Sergey-V-Z/IR_Controller/Schem/IRController/IRController1.jpg

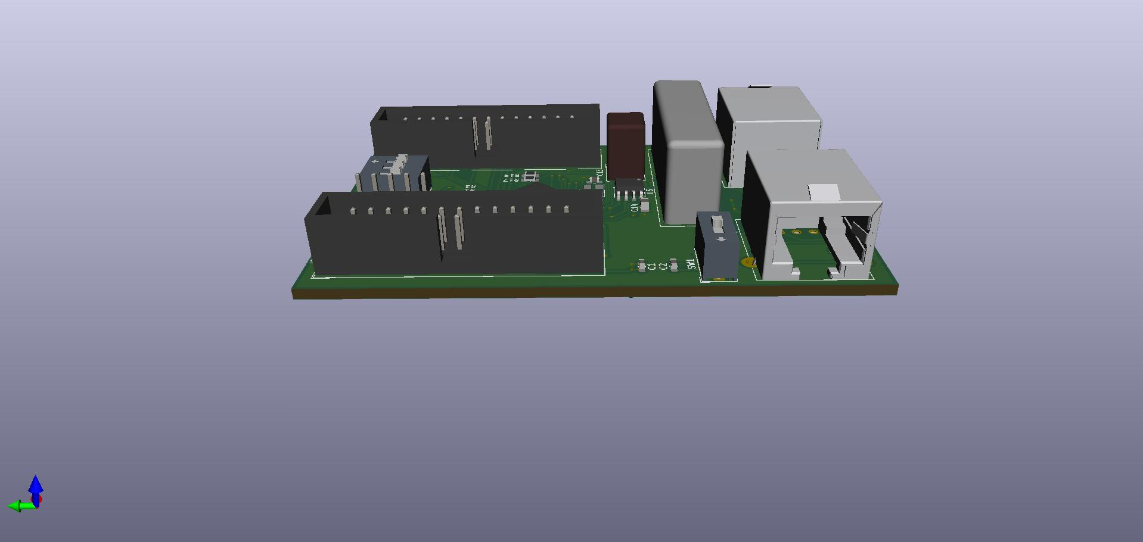
Schem/IRController/IRController1.jpg
