Sergey-V-Z/IR_Controller/Schem/IRController/IRController2.jpg

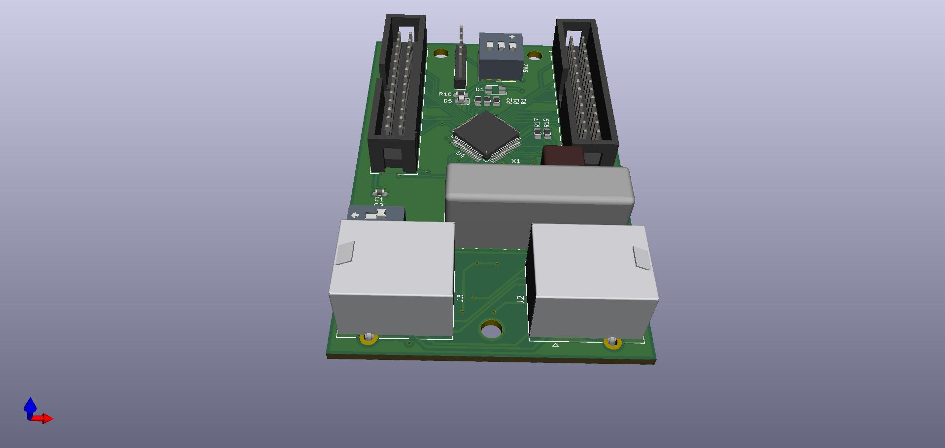
Schem/IRController/IRController2.jpg
