Sergey-V-Z/IR_Controller/Schem/IRController/IRController3.jpg

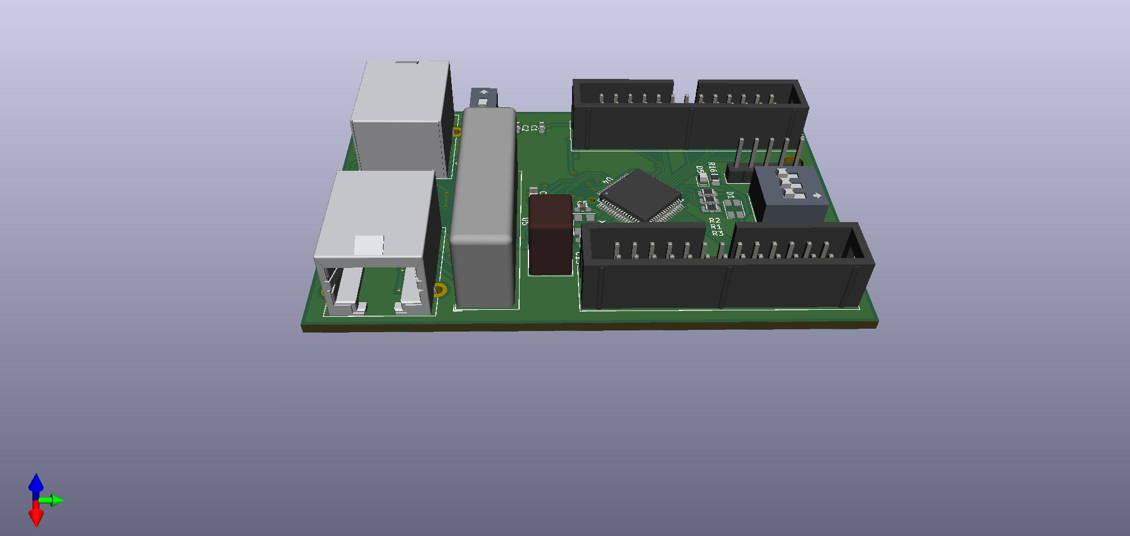
Schem/IRController/IRController3.jpg
