Sergey-V-Z/IR_Controller/Schem/IRController/IRController4.jpg

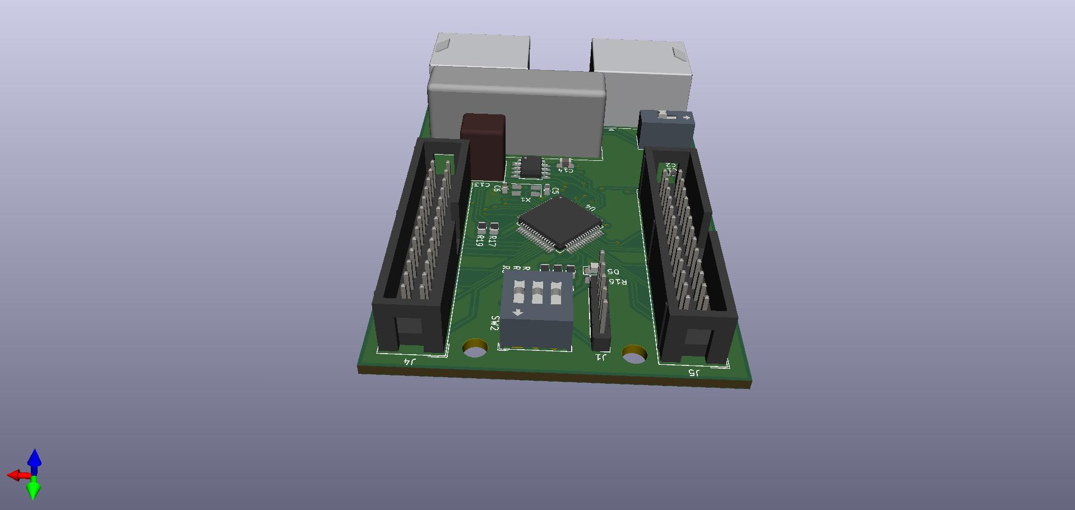
Schem/IRController/IRController4.jpg
