Sergey-V-Z/IR_Controller/Schem/IRController/IRController5.jpg

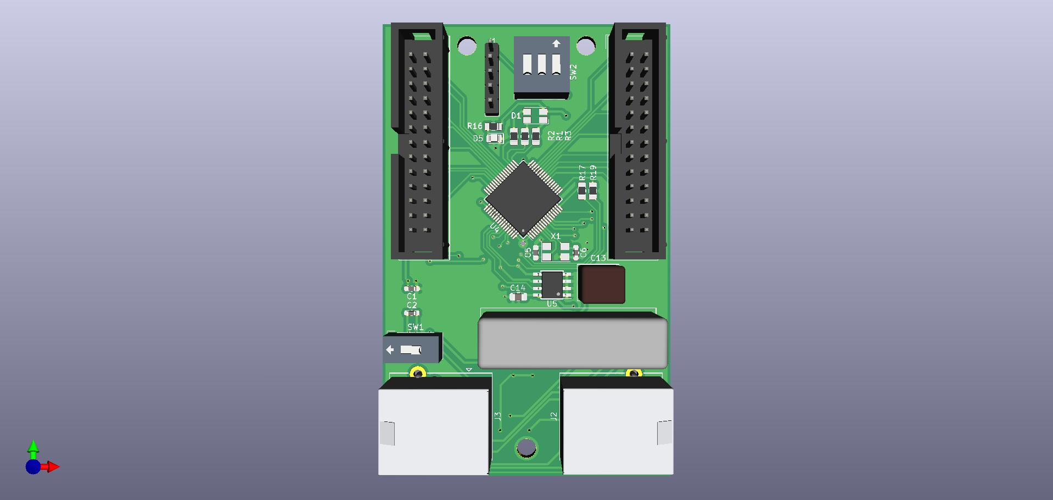
Schem/IRController/IRController5.jpg
