Sergey-V-Z/IR_Controller/Schem/IRController/IRController6.jpg

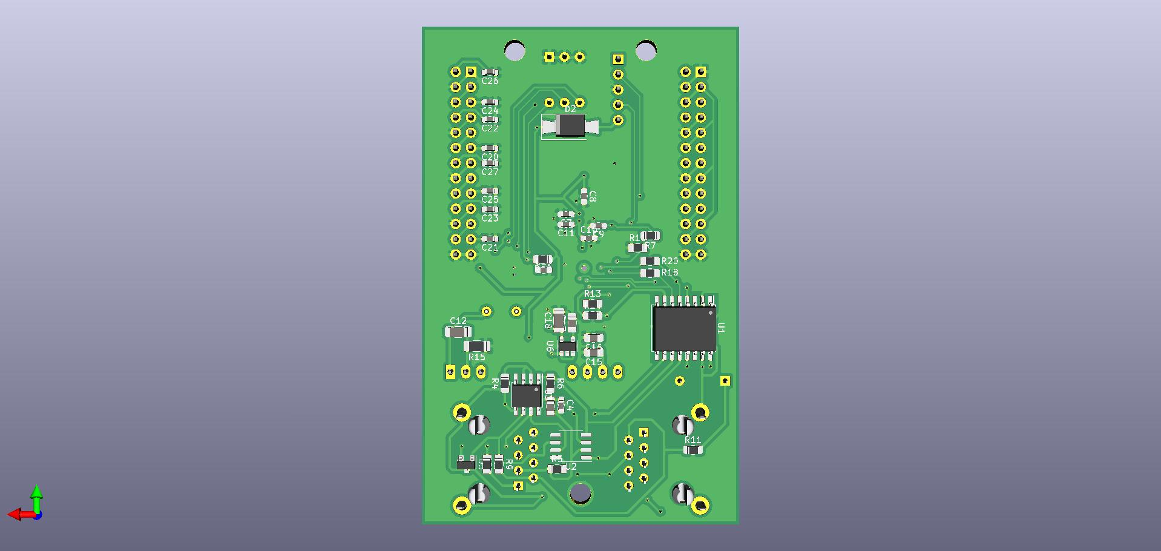
Schem/IRController/IRController6.jpg
