Sergey-V-Z/IR_Controller/Schem/IRController/IRController.kicad_pcb

## KiCad design Schem/IRController/IRController.kicad_pcb (2020-07-14)

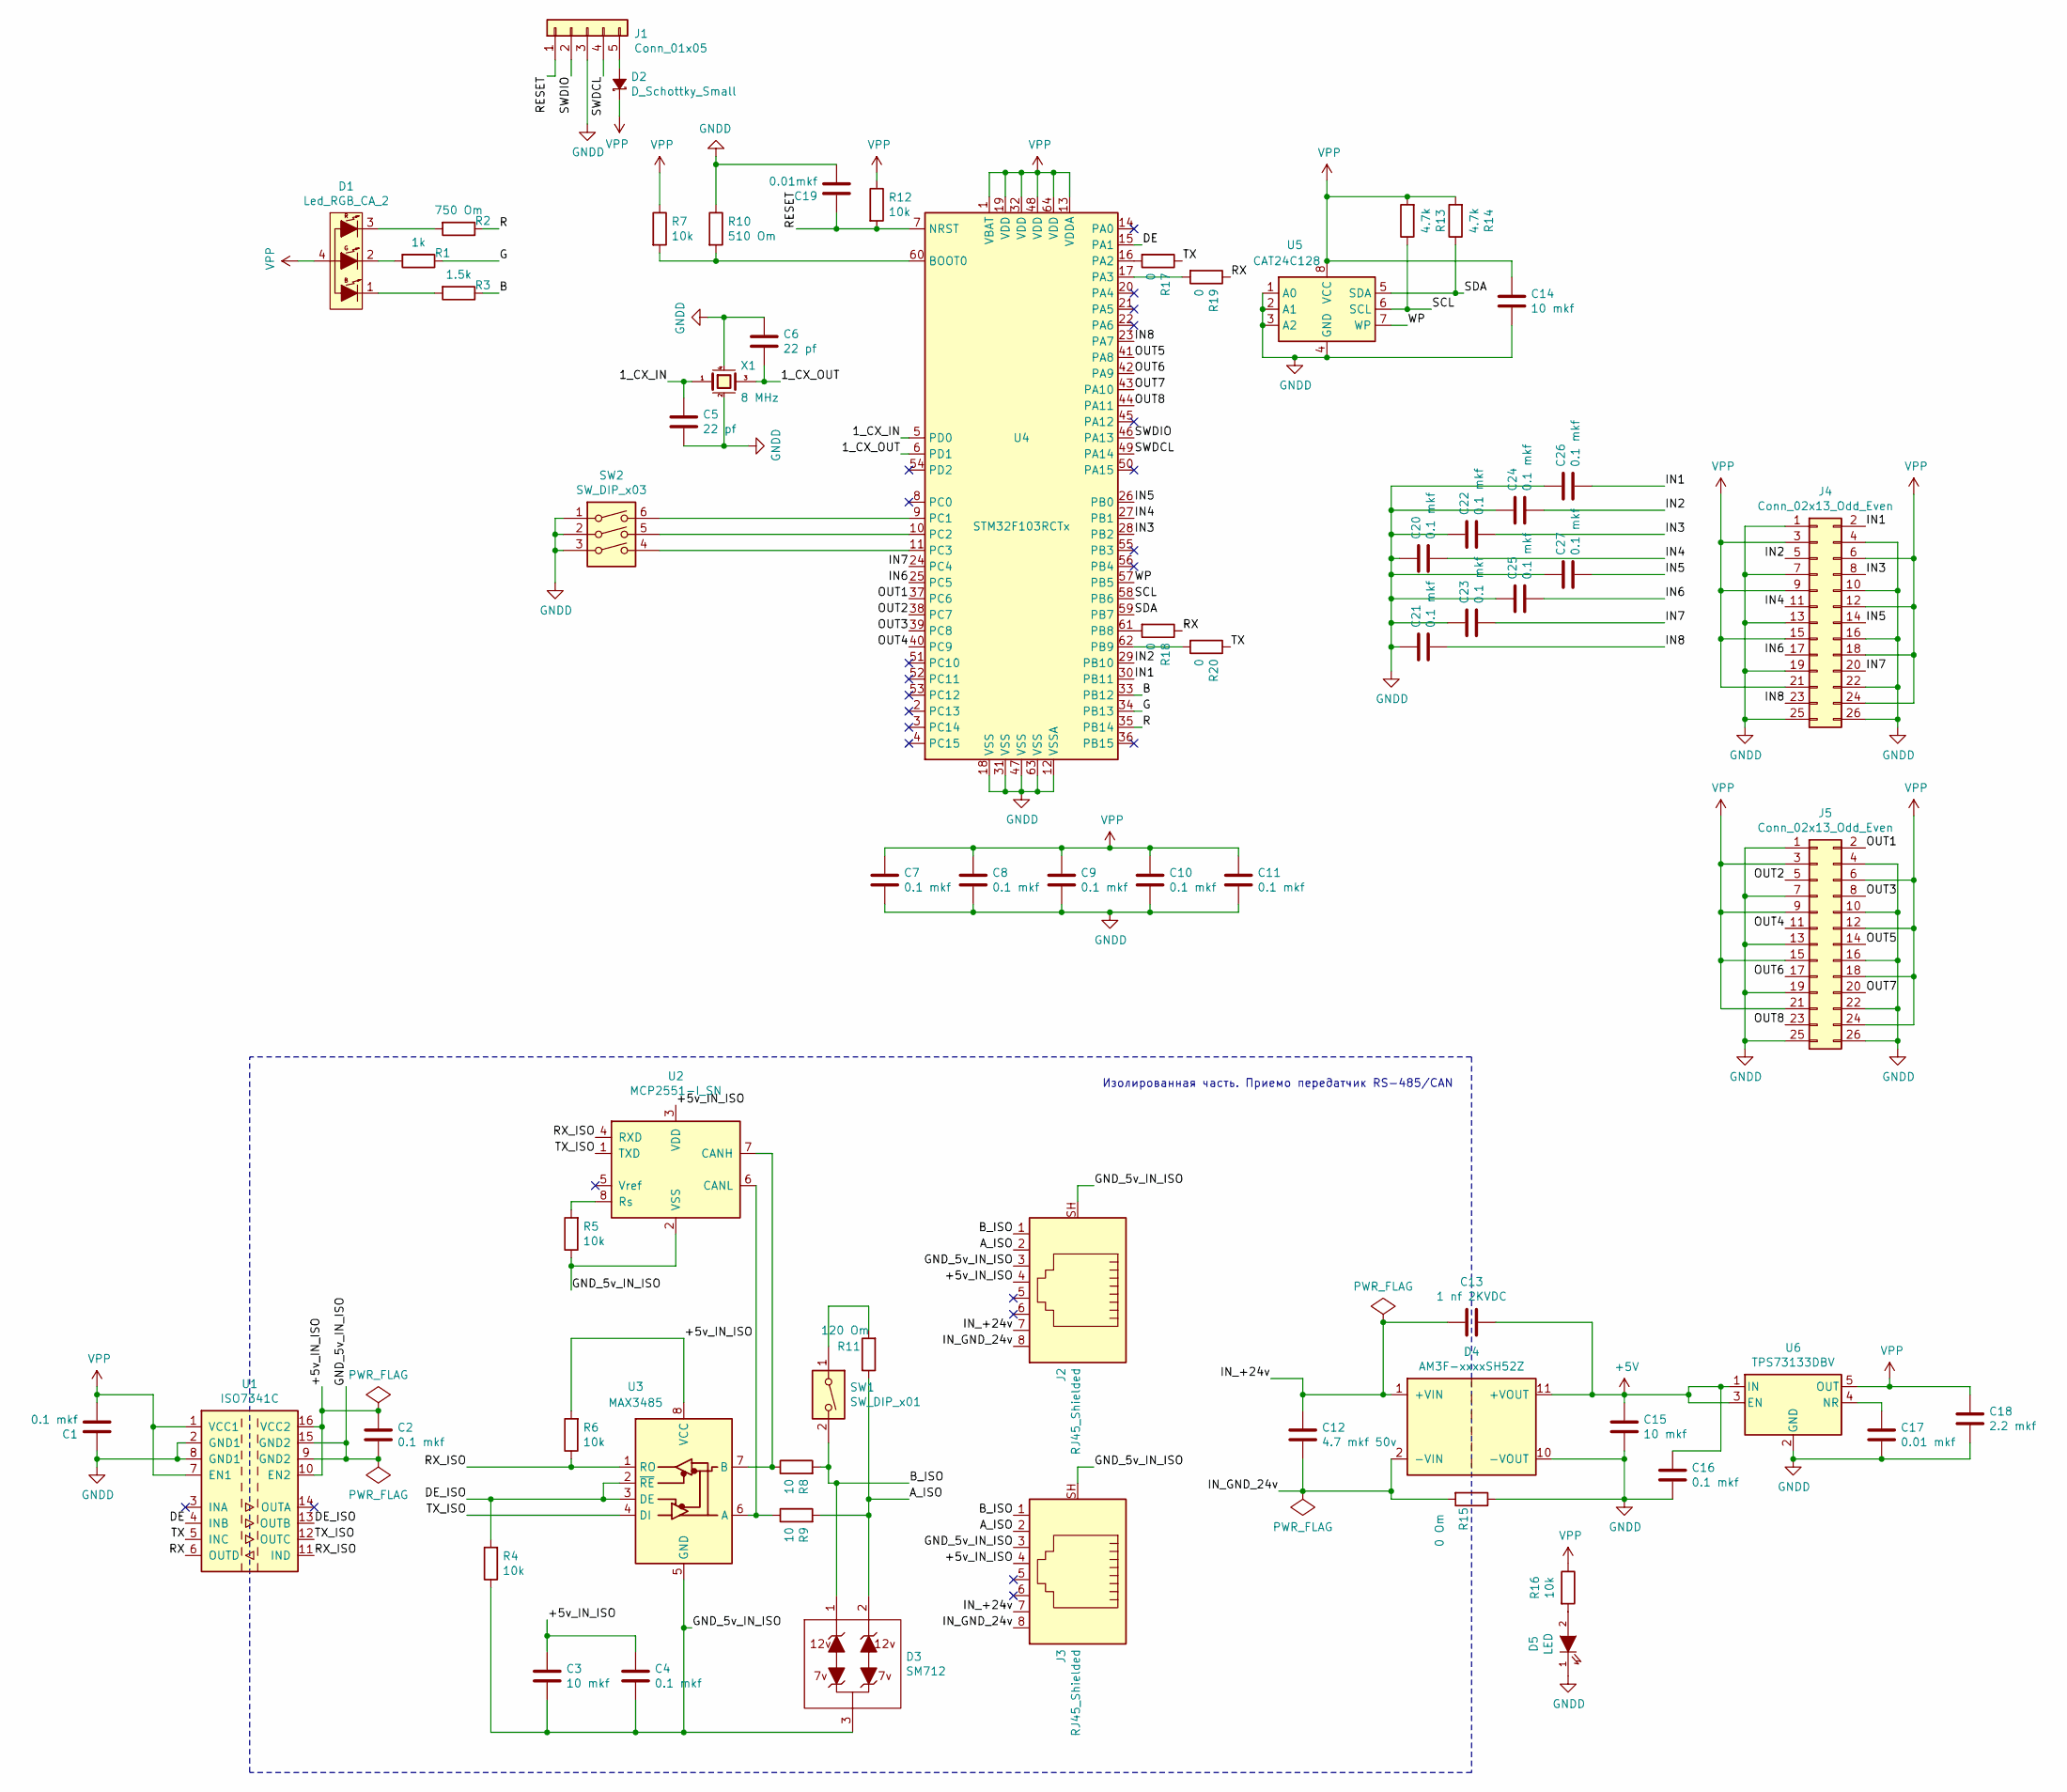
[picture p7: schematic IRController.sch]

Parts:
C1, C2, C4, C7, C8, C9, C10, C11, C20, C21, C22, C23, C24, C25, C26, C27: 0.1 mkf; C_0603_1608Metric_Pad1.05x0.95mm_HandSolder
C3, C14, C15: 10 mkf; C_0805_2012Metric_Pad1.15x1.40mm_HandSolder
C5, C6: 22 pf; C_0603_1608Metric_Pad1.05x0.95mm_HandSolder
C12: 4.7 mkf 50v; C_1206_3216Metric_Pad1.42x1.75mm_HandSolder
C13: 1 nf 2KVDC; C_Rect_L7.5mm_W6.5mm_P5.00mm
C16: 0.1 mkf; C_0805_2012Metric_Pad1.15x1.40mm_HandSolder
C17: 0.01 mkf; C_0805_2012Metric_Pad1.15x1.40mm_HandSolder
C18: 2.2 mkf; C_1206_3216Metric
C19: 0.01mkf; C_0603_1608Metric_Pad1.05x0.95mm_HandSolder
D1: Led_RGB_CA_2; LED_Avago_PLCC4_3.2x2.8mm_CW
D2: D_Schottky_Small; D_SMA-SMB_Universal_Handsoldering
D3: SM712; SOT-23
D4: AM3F-xxxxSH52Z; Converter_DCDC_AM3F-xxxxSH52Z_THT
D5: LED; LED_0805_2012Metric
J1: Conn_01x05; PinHeader_1x05_P2.54mm_Vertical
J2, J3: RJ45_Shielded; RJ45_Ninigi_GE
J4, J5: Conn_02x13_Odd_Even; IDC-Header_2x13_P2.54mm_Vertical
R1: 1k; R_0805_2012Metric_Pad1.15x1.40mm_HandSolder
R2: 750 Om; R_0805_2012Metric_Pad1.15x1.40mm_HandSolder
R3: 1.5k; R_0805_2012Metric_Pad1.15x1.40mm_HandSolder
R4, R5, R6, R7, R12, R16: 10k; R_0805_2012Metric_Pad1.15x1.40mm_HandSolder
R8, R9: 10; R_0805_2012Metric_Pad1.15x1.40mm_HandSolder
R10: 510 Om; R_0805_2012Metric_Pad1.15x1.40mm_HandSolder
R11: 120 Om; R_0805_2012Metric_Pad1.15x1.40mm_HandSolder
R13, R14: 4.7k; R_0805_2012Metric_Pad1.15x1.40mm_HandSolder
R15: 0 Om; R_1206_3216Metric_Pad1.42x1.75mm_HandSolder
R17, R18, R19, R20: 0; R_0805_2012Metric_Pad1.15x1.40mm_HandSolder
SW1: SW_DIP_x01; SW_DIP_SPSTx01_Slide_9.78x4.72mm_W7.62mm_P2.54mm
SW2: SW_DIP_x03; SW_DIP_SPSTx03_Slide_9.78x9.8mm_W7.62mm_P2.54mm
U1: ISO7341C; SOIC-16W_7.5x10.3mm_P1.27mm
U2: MCP2551-I_SN; SO-8_3.9x4.9mm_P1.27mm
U3: MAX3485; SOIC-8_3.9x4.9mm_P1.27mm
U4: STM32F103RCTx; LQFP-64_10x10mm_P0.5mm
U5: CAT24C128; SOIC-8_3.9x4.9mm_P1.27mm
U6: TPS73133DBV; SOT-23-5
X1: 8 MHz; Crystal_SMD_5032-4Pin_5.0x3.2mm

Connections:
+5V: C13.1, C15.1, C16.1, D4.11 (+VOUT), U6.1 (IN), U6.3 (EN)
/1_CX_IN: C5.1, U4.5 (PD0), X1.1
/1_CX_OUT: C6.2, U4.6 (PD1), X1.3
/+5v_IN_ISO: C2.1, C3.1, C4.1, J2.4, J3.4, R6.2, U1.10 (EN2), U1.16 (VCC2), U2.3 (VDD), U3.8 (VCC)
/A_ISO: D3.2, J2.2, J3.2, R9.2, R11.1
/B: R3.1, U4.33 (PB12)
/B_ISO: D3.1, J2.1, J3.1, R8.2, SW1.2
/DE: U1.4 (INB), U4.15 (PA1)
/DE_ISO: R4.2, U1.13 (OUTB), U3.2 (~RE), U3.3 (DE)
/G: R1.1, U4.34 (PB13)
/GND_5v_IN_ISO: C2.2, C3.2, C4.2, D3.3, J2.3, J2.SH, J3.3, J3.SH, R4.1, R5.1, U1.9 (GND2), U1.15 (GND2), U2.2 (VSS), U3.5 (GND)
/IN1: C26.2, J4.2, U4.30 (PB11)
/IN2: C24.2, J4.5, U4.29 (PB10)
/IN3: C22.2, J4.8, U4.28 (PB2)
/IN4: C20.2, J4.11, U4.27 (PB1)
/IN5: C27.2, J4.14, U4.26 (PB0)
/IN6: C25.2, J4.17, U4.25 (PC5)
/IN7: C23.2, J4.20, U4.24 (PC4)
/IN8: C21.2, J4.23, U4.23 (PA7)
/IN_+24v: C12.1, C13.2, D4.1 (+VIN), J2.7, J3.7
/IN_GND_24v: C12.2, D4.2 (-VIN), J2.8, J3.8, R15.2
/OUT1: J5.2, U4.37 (PC6)
/OUT2: J5.5, U4.38 (PC7)
/OUT3: J5.8, U4.39 (PC8)
/OUT4: J5.11, U4.40 (PC9)
/OUT5: J5.14, U4.41 (PA8)
/OUT6: J5.17, U4.42 (PA9)
/OUT7: J5.20, U4.43 (PA10)
/OUT8: J5.23, U4.44 (PA11)
/R: R2.1, U4.35 (PB14)
/RESET: C19.1, J1.1, R12.2, U4.7 (NRST)
/RX: R18.1, R19.1, U1.6 (OUTD)
/RX_ISO: R6.1, U1.11 (IND), U2.4 (RXD), U3.1 (RO)
/SCL: R13.1, U4.58 (PB6), U5.6 (SCL)
/SDA: R14.1, U4.59 (PB7), U5.5 (SDA)
/SWDCL: J1.4, U4.49 (PA14)
/SWDIO: J1.2, U4.46 (PA13)
/TX: R17.1, R20.1, U1.5 (INC)
/TX_ISO: U1.12 (OUTC), U2.1 (TXD), U3.4 (DI)
/WP: U4.57 (PB5), U5.7 (WP)
GNDD: C1.1, C5.2, C6.1, C7.2, C8.2, C9.2, C10.2, C11.2, C14.2, C15.2, C16.2, C17.2, C18.2, C19.2, C20.1, C21.1, C22.1, C23.1, C24.1, C25.1, C26.1, C27.1, D4.10 (-VOUT), D5.1 (K), J1.3, J4.1, J4.4, J4.7, J4.10, J4.13, J4.16, J4.19, J4.22, J4.25, J4.26, J5.1, J5.4, J5.7, J5.10, J5.13, J5.16, J5.19, J5.22, J5.25, J5.26, R10.1, R15.1, SW2.1, SW2.2, SW2.3, U1.2 (GND1), U1.8 (GND1), U4.12 (VSSA), U4.18 (VSS), U4.31 (VSS), U4.47 (VSS), U4.63 (VSS), U5.1 (A0), U5.2 (A1), U5.3 (A2), U5.4 (GND), U6.2 (GND), X1.2 (case), X1.4 (case)
unnamed: C17.1, U6.4 (NR)
unnamed: D1.1 (B), R3.2
unnamed: D1.2 (G), R1.2
unnamed: D1.3 (R), R2.2
unnamed: D2.2 (A), J1.5
unnamed: D5.2 (A), R16.2
unnamed: R5.2, U2.8 (Rs)
unnamed: R8.1, U2.7 (CANH), U3.7 (B)
unnamed: R9.1, U2.6 (CANL), U3.6 (A)
unnamed: R7.2, R10.2, U4.60 (BOOT0)
unnamed: R11.2, SW1.1
unnamed: R17.2, U4.16 (PA2)
unnamed: R18.2, U4.61 (PB8)
unnamed: R19.2, U4.17 (PA3)
unnamed: R20.2, U4.62 (PB9)
unnamed: SW2.4, U4.11 (PC3)
unnamed: SW2.5, U4.10 (PC2)
unnamed: SW2.6, U4.9 (PC1)
VPP: C1.2, C7.1, C8.1, C9.1, C10.1, C11.1, C14.1, C18.1, D1.4, D2.1 (K), J4.3, J4.6, J4.9, J4.12, J4.15, J4.18, J4.21, J4.24, J5.3, J5.6, J5.9, J5.12, J5.15, J5.18, J5.21, J5.24, R7.1, R12.1, R13.2, R14.2, R16.1, U1.1 (VCC1), U1.7 (EN1), U4.1 (VBAT), U4.13 (VDDA), U4.19 (VDD), U4.32 (VDD), U4.48 (VDD), U4.64 (VDD), U5.8 (VCC), U6.5 (OUT)

Notes on the sheet:
Изолированная часть. Приемо передатчик RS-485/CAN

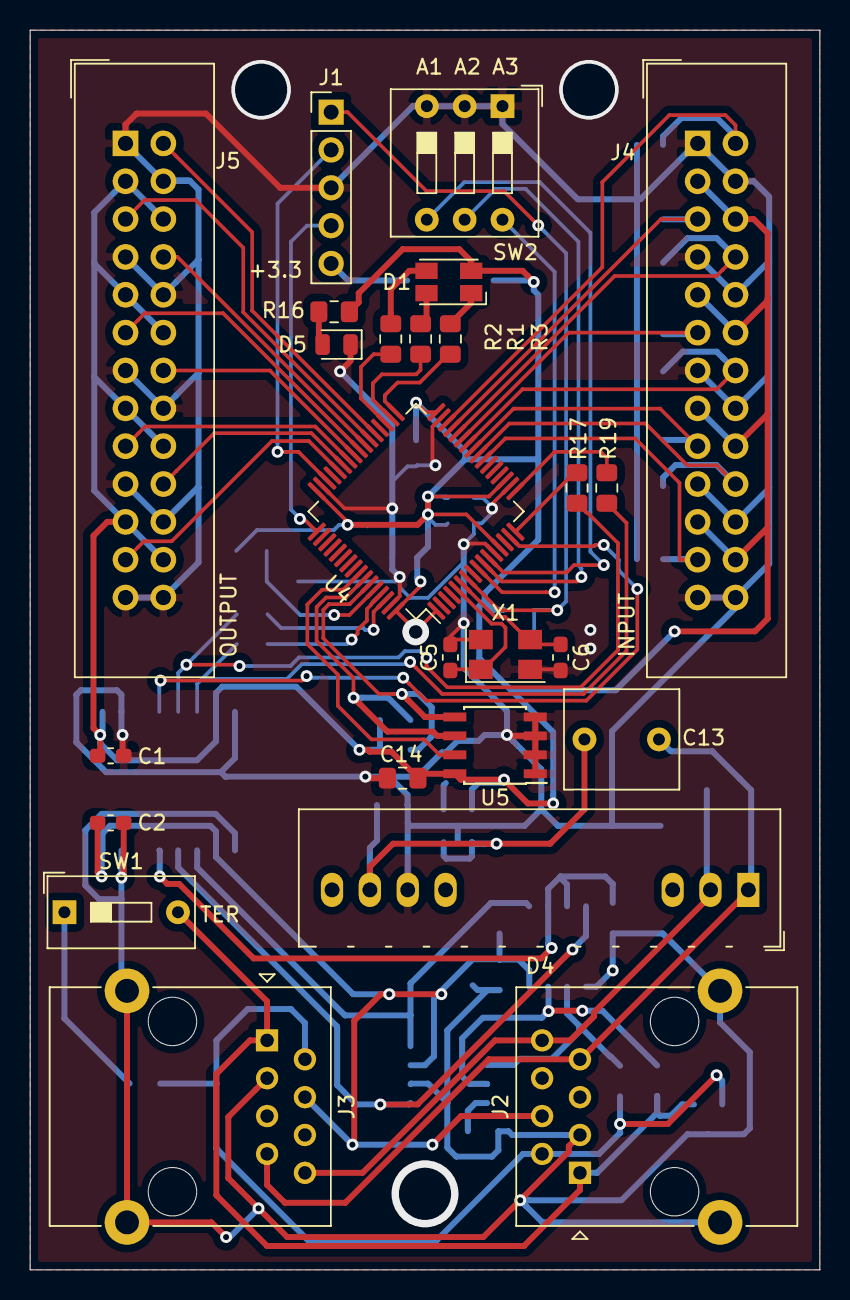
[picture p8: board IRController.kicad_pcb from above]

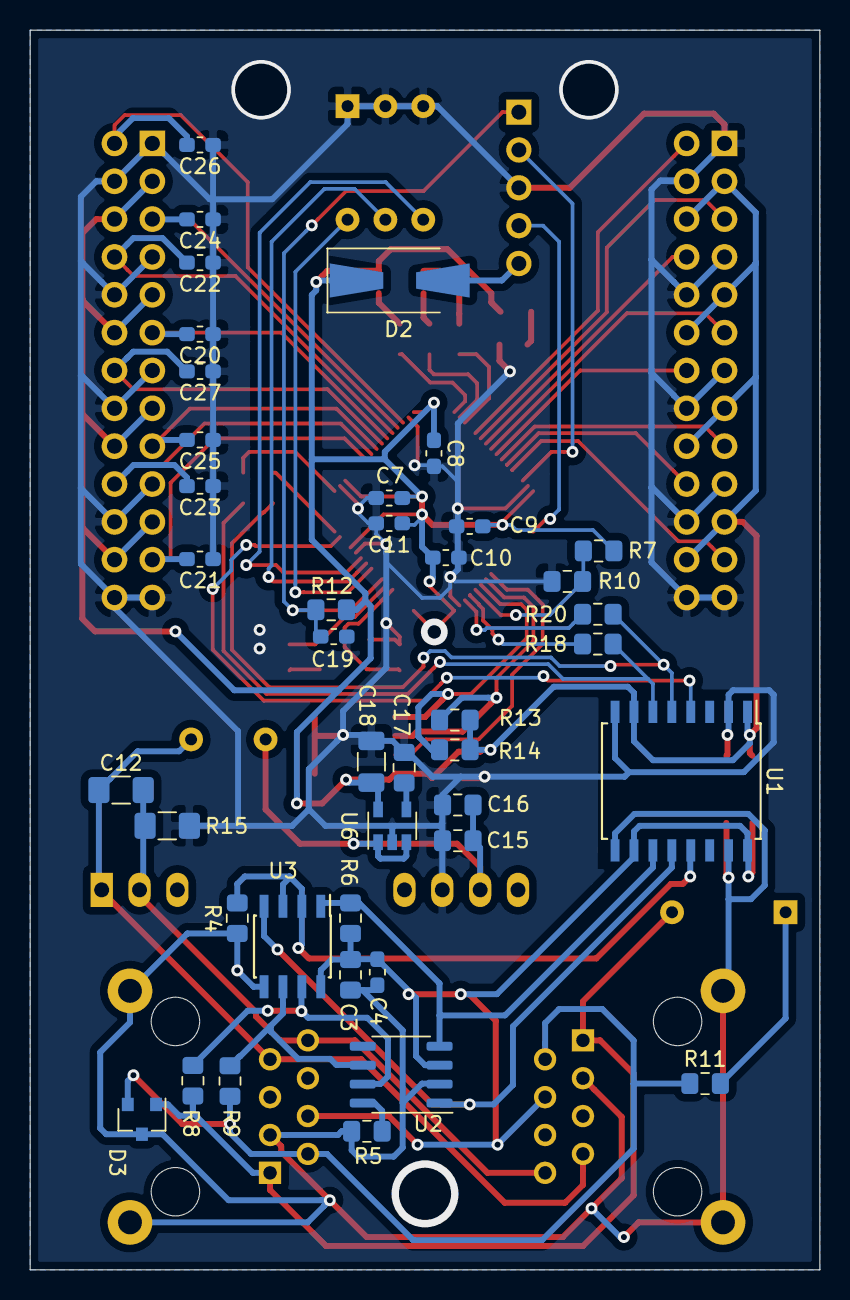
[picture p9: board IRController.kicad_pcb from below]

Board: 2 copper layers, 53.0 x 83.2 mm, 66 parts (41 on the bottom side), 60 nets.
