Sergey-V-Z/IR_Controller/IRControll_Programm/IRControll_Programm.ioc

Mcu.UserName=STM32F103RCTx
PA1.GPIO_Label=DE
PA1.Signal=GPIO_Output
PA10.GPIO_Label=OUT7
PA10.Signal=S_TIM1_CH3
PA11.GPIO_Label=OUT8
PA11.Signal=S_TIM1_CH4
PA13.Signal=SYS_JTMS-SWDIO
PA14.Signal=SYS_JTCK-SWCLK
PA2.Signal=USART2_TX
PA3.Signal=USART2_RX
PA7.GPIO_Label=IN8
PA7.Signal=GPIO_Input
PA8.GPIO_Label=OUT5
PA8.Signal=S_TIM1_CH1
PA9.GPIO_Label=OUT6
PA9.Signal=S_TIM1_CH2
PB0.GPIO_Label=IN5
PB0.Signal=GPIO_Input
PB1.GPIO_Label=IN4
PB1.Signal=GPIO_Input
PB10.GPIO_Label=IN2
PB10.Signal=GPIO_Input
PB11.GPIO_Label=IN1
PB11.Signal=GPIO_Input
PB12.GPIO_Label=B
PB12.Signal=GPIO_Output
PB13.GPIO_Label=G
PB13.Signal=GPIO_Output
PB14.GPIO_Label=R
PB14.Signal=GPIO_Output
PB2.GPIO_Label=IN3
PB2.Signal=GPIO_Input
PB6.Signal=I2C1_SCL
PB7.Signal=I2C1_SDA
PC1.Signal=GPIO_Input
PC2.Signal=GPIO_Input
PC3.Signal=GPIO_Input
PC4.GPIO_Label=IN7
PC4.Signal=GPIO_Input
PC5.GPIO_Label=IN6
PC5.Signal=GPIO_Input
PC6.GPIO_Label=OUT1
PC6.Signal=S_TIM8_CH1
PC7.GPIO_Label=OUT2
PC7.Signal=S_TIM8_CH2
PC8.GPIO_Label=OUT3
PC8.Signal=S_TIM8_CH3
PC9.GPIO_Label=OUT4
PC9.Signal=S_TIM8_CH4
PD0-OSC_IN.Signal=RCC_OSC_IN
PD1-OSC_OUT.Signal=RCC_OSC_OUT
