Sergey-V-Z/IR_Controller/f303/f303_sens/Inc/sensor.h

#include "filter_sma.h"
#include "cmsis_os.h"

//******************
// CLASS: sensor
//
// DESCRIPTION:
//  distance optical sensor class
//
// CREATED: 03.03.2021, by Sergey
//
// FILE: sensor.h
//
class sensor: public filter{
  public:
   sensor();
   ~sensor();
   void setOffsetMin(uint16_t offset);
   void setOffsetMax(uint16_t offset);
   uint16_t getOffsetMin();
   uint16_t getOffsetMax();
   bool detectPoll();
   bool getdetect();
   void Call(uint16_t *data); // калибрует датчик, принимает указатель на переменную в которую поступаю свежие данные
   
  private:
   uint16_t offsetMin = 0;              // зона работы датчика
   uint16_t offsetMax = 4096;           // зона работы датчика
   uint32_t timeCall = 3000;            // время выполнение калибровки
   bool detect;                         // в зоне сенсора что то есть
};
