Sergey-V-Z/IR_Controller/IRControll_Programm/Inc/main.h

#define DE_Pin GPIO_PIN_1
#define DE_GPIO_Port GPIOA
#define IN8_Pin GPIO_PIN_7
#define IN8_GPIO_Port GPIOA
#define IN7_Pin GPIO_PIN_4
#define IN7_GPIO_Port GPIOC
#define IN6_Pin GPIO_PIN_5
#define IN6_GPIO_Port GPIOC
#define IN5_Pin GPIO_PIN_0
#define IN5_GPIO_Port GPIOB
#define IN4_Pin GPIO_PIN_1
#define IN4_GPIO_Port GPIOB
#define IN3_Pin GPIO_PIN_2
#define IN3_GPIO_Port GPIOB
#define IN2_Pin GPIO_PIN_10
#define IN2_GPIO_Port GPIOB
#define IN1_Pin GPIO_PIN_11
#define IN1_GPIO_Port GPIOB
#define B_Pin GPIO_PIN_12
#define B_GPIO_Port GPIOB
#define G_Pin GPIO_PIN_13
#define G_GPIO_Port GPIOB
#define R_Pin GPIO_PIN_14
#define R_GPIO_Port GPIOB
#define OUT1_Pin GPIO_PIN_6
#define OUT1_GPIO_Port GPIOC
#define OUT2_Pin GPIO_PIN_7
#define OUT2_GPIO_Port GPIOC
#define OUT3_Pin GPIO_PIN_8
#define OUT3_GPIO_Port GPIOC
#define OUT4_Pin GPIO_PIN_9
#define OUT4_GPIO_Port GPIOC
#define OUT5_Pin GPIO_PIN_8
#define OUT5_GPIO_Port GPIOA
#define OUT6_Pin GPIO_PIN_9
#define OUT6_GPIO_Port GPIOA
#define OUT7_Pin GPIO_PIN_10
#define OUT7_GPIO_Port GPIOA
#define OUT8_Pin GPIO_PIN_11
#define OUT8_GPIO_Port GPIOA
