Sergey-V-Z/IR_Controller/(commit log)

2020-07-14 Первый
    [IRController-B_Cu.gbr, IRController-B_Mask.gbr, IRController-B_Paste.gbr, IRController-B_SilkS.gbr, IRController-Edge_Cuts.gbr, IRController-F_Cu.gbr, IRController-F_Mask.gbr, IRController-F_Paste.gbr]
2021-03-02 Sensors add
    [Map Registers.xlsx]
2021-03-10 F303 probe
    [Map Registers.xlsx]
2021-03-10 f303
    Переписал на f303 исправил ошибки
    [IRControll_Programm.ioc, f303_sens.ioc]
