Sergey-V-Z/IR_Controller/(notices)

Notices in the files:
IRControll_Programm/Inc/main.h:
© Copyright (c) 2020 STMicroelectronics.
All rights reserved.
This software component is licensed by ST under Ultimate Liberty license
